tjgilbert/ece411/README.md

## ECE411 Practicum Project

**Project Focus:** Inductive Charging

**Team 10:** Jeff Brown, Katie Dahn, Tyler Gilbert, Jann Messer

*  [Project Wiki] (https://github.com/tjgilbert/ece411/wiki)
