tjgilbert/ece411/Docs/Assignment Docs/Homework3 source/ref.tex

\phantomsection
\addcontentsline{toc}{section}{References} %References don't show up in TOC on their own

\begin{thebibliography}{}

\bibitem{lecture}
Faust, Mark. "Requirements Specification" ECE 411 Industry Design Practices. Portland State University, Portland, OR. 18 October 2016. Lecture/PowerPoint

\bibitem{USB20}
"Universal Serial Bus Specification Revision 2.0"
\emph{Compaq Computer Corporation,
Hewlett-Packard Company, Intel Corporation, Lucent Technologies Inc,
Microsoft Corporation, NEC Corporation, Koninklijke Philips Electronics N.V.} \small{[\href{http://www.pjrc.com/teensy/beta/usb20.pdf\#page=206}{PDF DOCUMENT}]}, \normalsize 2000
 
\bibitem{appletemp}
"Keeping IPhone, IPad, and IPod Touch within Acceptable Operating Temperatures."
\emph{Apple Support.} N.p., 28 Sept. 2016. Web. 24 Oct. 2016. \url{https://support.apple.com/en-us/HT201678}

\bibitem{iprating}
"IP Rated Enclosures Explained"
\emph{The Enclosure Company (International) Ltd} N.p., n.d. Web. 23 Oct. 2016. \url{http://www.enclosurecompany.com/ip-ratings-explained.php}

\bibitem{forbes}
"How Often Do Americans Upgrade Their Smartphones?" \emph{Forbes.} Forbes Magazine, 9 July, 2015. Web. 24 Oct. 2016.

\rhead{ \fancyplain{}{References} }

\end{thebibliography}
% that's all folks
