tjgilbert/ece411/Docs/Presentation/PowerPointT10.pptx

## A Modest Inductive Charger

Team 10 – Jeff Brown Kati Dahn Tyler Gilbert Jann Messer

## Pitfalls of Wired Charging

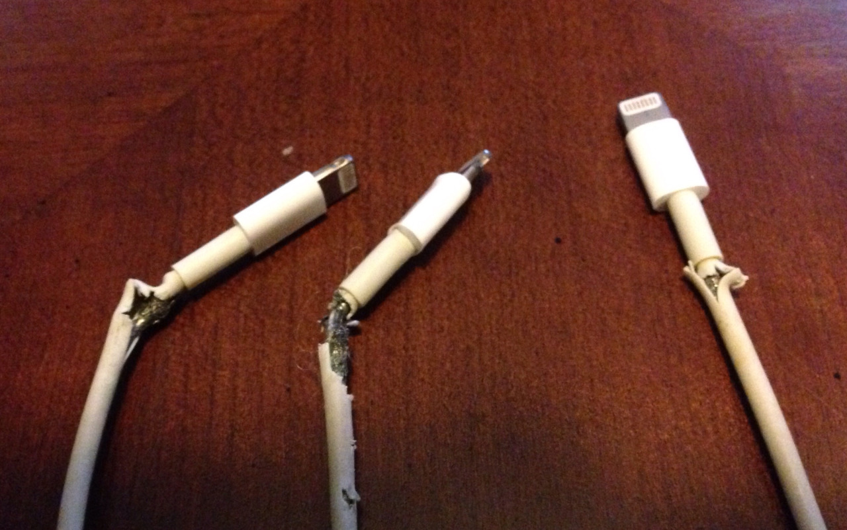
[picture p1: figure]
Image result for frayed usb cord
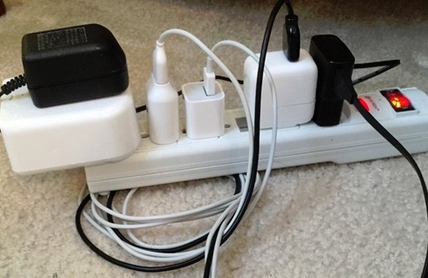
[picture p2: figure]
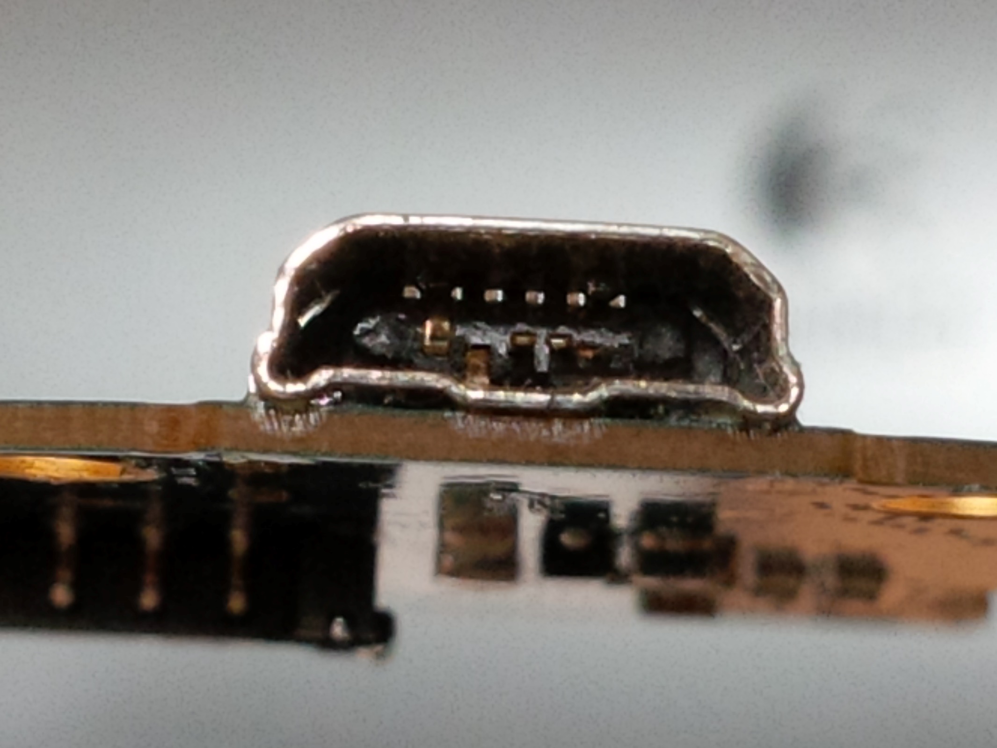
[picture p3: figure]

## Guiding Motivation

- “To become more familiar with wireless energy transmission and explore integrating wireless charging technology into consumer electronics.”
- A starting point for exploring Power solutions for the internet of things

## Objective

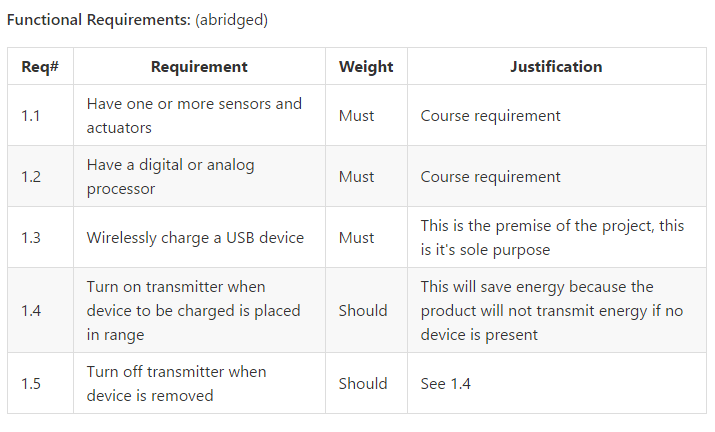
[picture p4: figure]
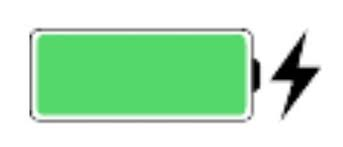
[picture p5: figure]
Image result for charging indicator icon

## Alternatives

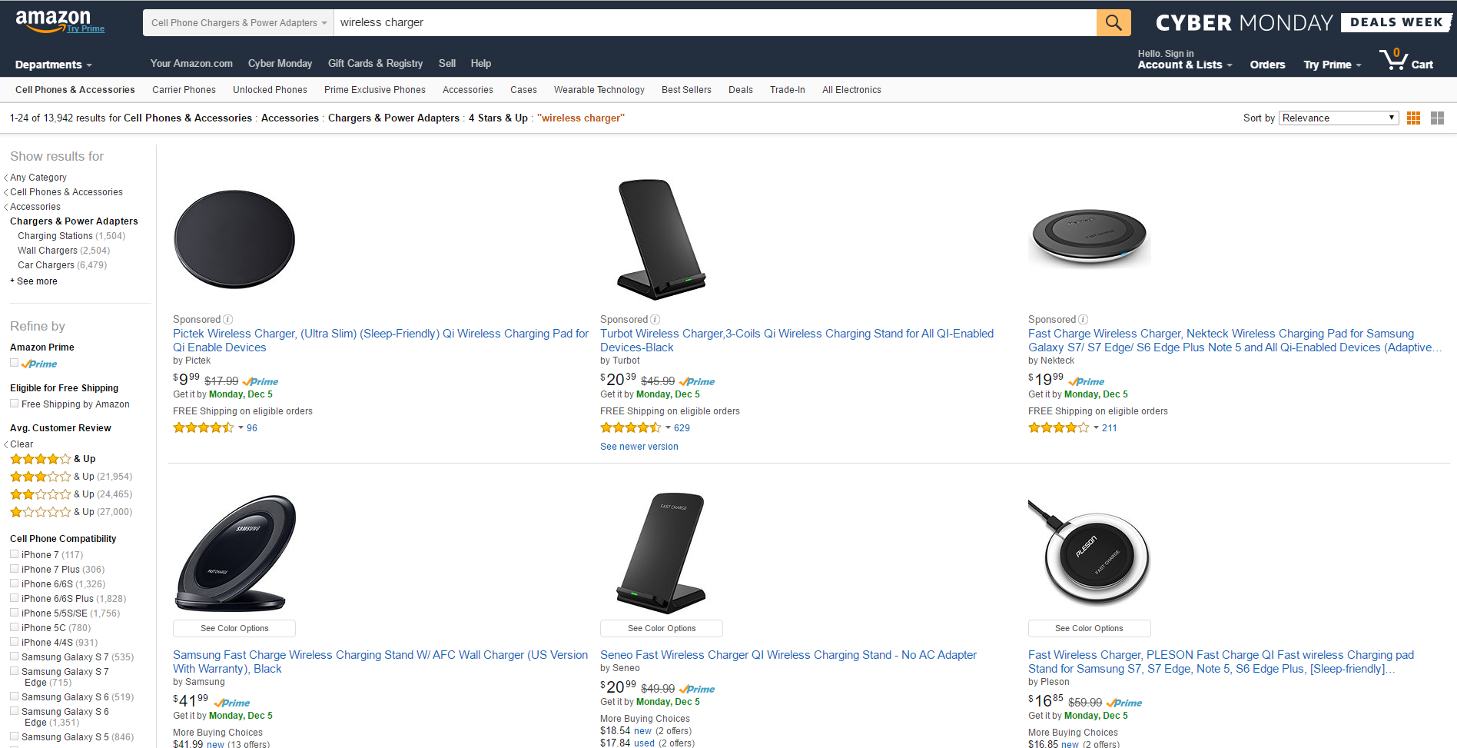
[picture p6: figure]
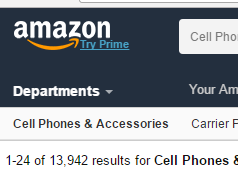
[picture p7: figure]

- We are by no means re-inventing the wheel here.

## Requirements

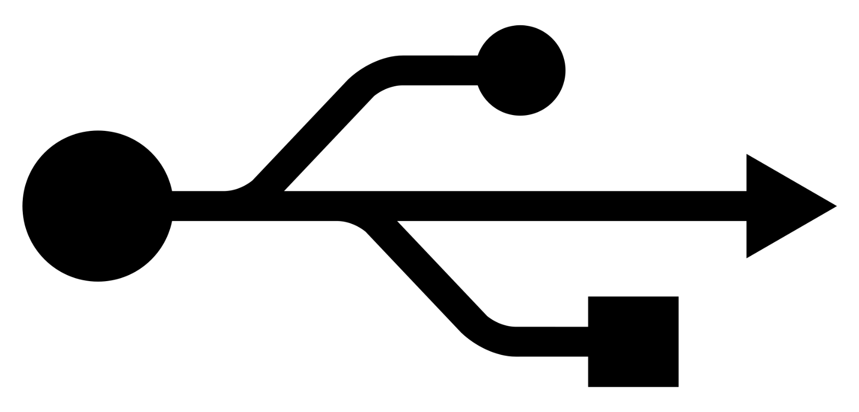
[picture p8: figure]
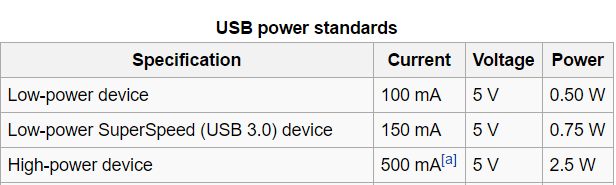
[picture p9: figure]

## Approach

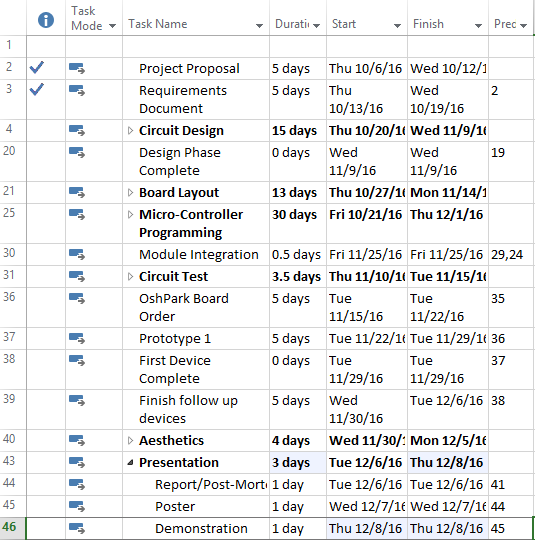
[picture p10: figure]

- Block Diagram of Modules
- Design Coils
- Design Signal Driver
- Program Controller
- Regulation and Rectification Circuitry
- Integration
- Testing

## Circuit Design

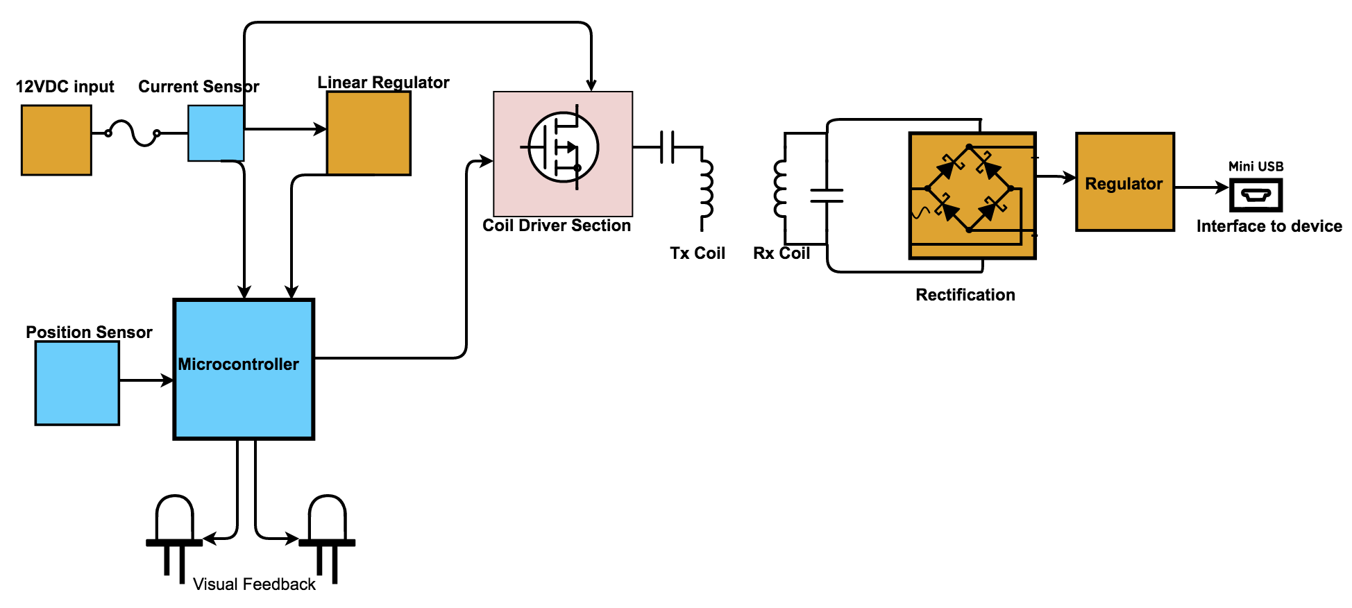
[picture p11: figure]

## Coil Design

## Driver Design

## Regulation and Rectification

## Microcontroller software Design

## Implementation slide 1 of 2

- Details

## Implementation 2 bill of materials and Tools

## IP and Prior WOrk

## Testing

## Results

## Contributions

## Lessons Learned
