tjgilbert/ece411/Docs/Assignment Docs/Homework3 source/title_toc.tex

\thispagestyle{empty}   % removes page numbering for title page

\begin{figure}[t]
    \begin{center}
    {\huge \textsc{ Product Design Specifications}}
    \end{center}

    \begin{center}
    \LARGE Inductive Charging
    \end{center}

    \begin{center}
    \normalsize \textit{Practicum Team 10}
    \end{center}
\end{figure}

\vspace*{\fill}

\begingroup
    \begin{center}
    
    \end{center}
\endgroup
    
\vspace*{\fill}
    
\begin{figure}[b]
    
\end{figure}

% Contact info footer
    \begin{figure}[!b]
    \begin{center}
    \rule{6in}{0.4pt}
    \begin{minipage}[t]{.75\textwidth}
    \begin{tabular}{llcccll}
    \textbf{Team Members:}  Tyler Gilbert, Kati Dahn, Jann Messer, Jeff Brown & & & &\\
    \textbf{Project repository:} \href{https://github.com/tjgilbert/ece411}{https://github.com/tjgilbert/ece411} \\
    \end{tabular}
    \end{minipage}
    \rule{6in}{0.4pt}
    \end{center}
    \end{figure}
    
\cleardoublepage
\phantomsection

\hypertarget{MyToc}{} %For linking back to the TOC
\rhead{ \fancyplain{}{Table of Contents} }
\begin{center}
{\Large \textsc{ Table of Contents}}
\end{center}
\renewcommand{\contentsname}{}
\tableofcontents

\cleardoublepage
