tjgilbert/ece411/HW6TitlePage.JPG

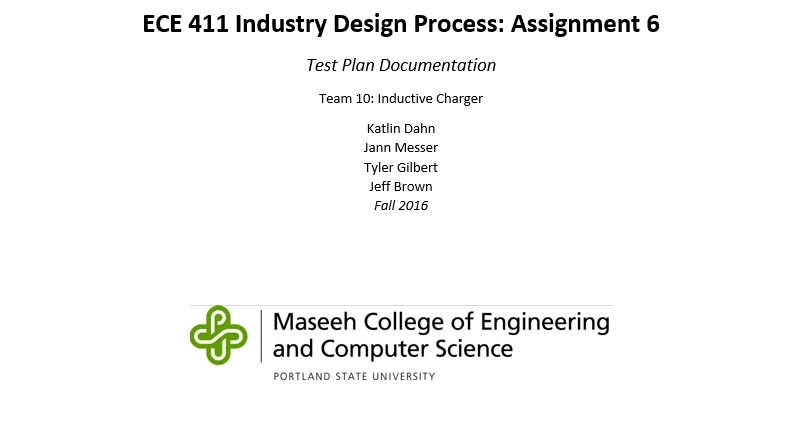
HW6TitlePage.JPG
