tjgilbert/ece411/ToCHW6.jpg

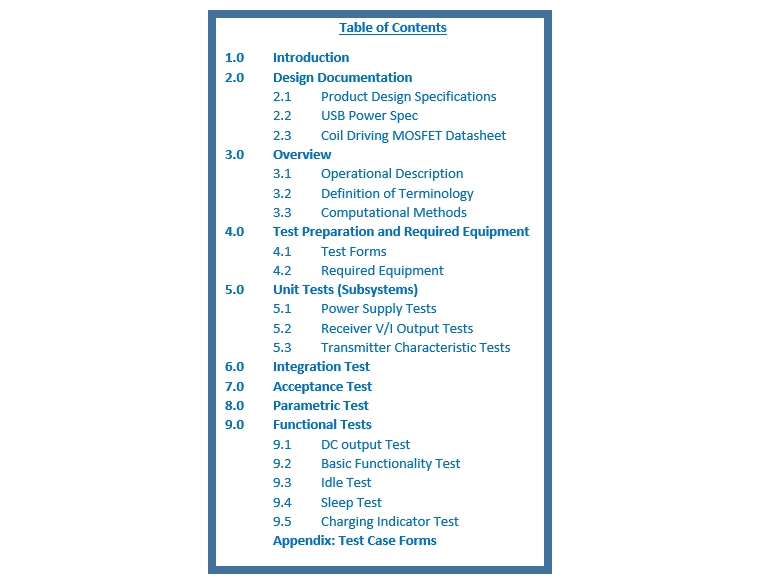
ToCHW6.jpg
