tjgilbert/ece411/Docs/Output-Stage-Tests/Capture 1.png

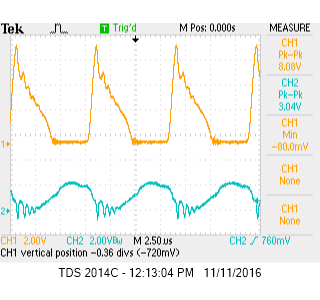
Docs/Output-Stage-Tests/Capture 1.png
