tjgilbert/ece411/Docs/Output-Stage-Tests/Capture 2.png

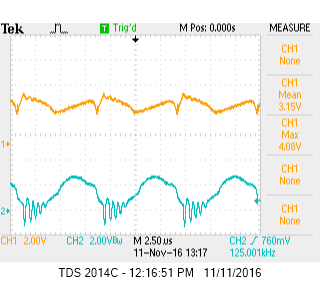
Docs/Output-Stage-Tests/Capture 2.png
