tjgilbert/ece411/Docs/Output-Stage-Tests/Capture 3.png

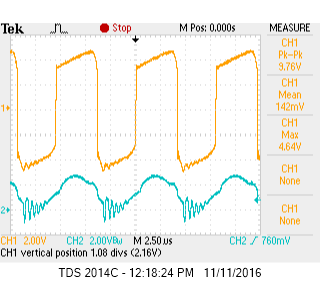
Docs/Output-Stage-Tests/Capture 3.png
