tjgilbert/ece411/Docs/Output-Stage-Tests/Capture 4.png

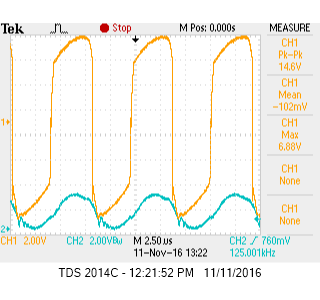
Docs/Output-Stage-Tests/Capture 4.png
