tjgilbert/ece411/Docs/Output-Stage-Tests/Capture 5.png

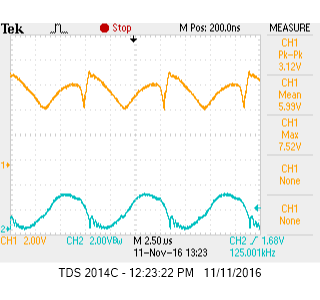
Docs/Output-Stage-Tests/Capture 5.png
