tjgilbert/ece411/Docs/Output-Stage-Tests/Capture 6.png

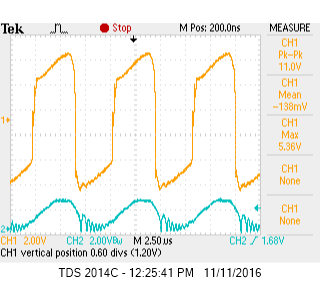
Docs/Output-Stage-Tests/Capture 6.png
