tjgilbert/ece411/Docs/Output-Stage-Tests/Capture 7.png

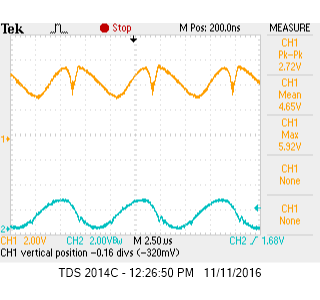
Docs/Output-Stage-Tests/Capture 7.png
