tjgilbert/ece411/Docs/Output-Stage-Tests/Capture 8.png

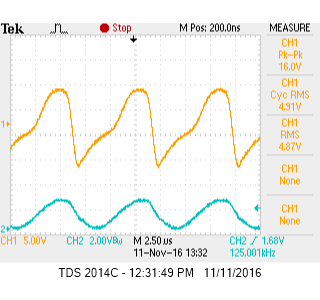
Docs/Output-Stage-Tests/Capture 8.png
