tjgilbert/ece411/Docs/Sample Charging Characterization/FFT.png

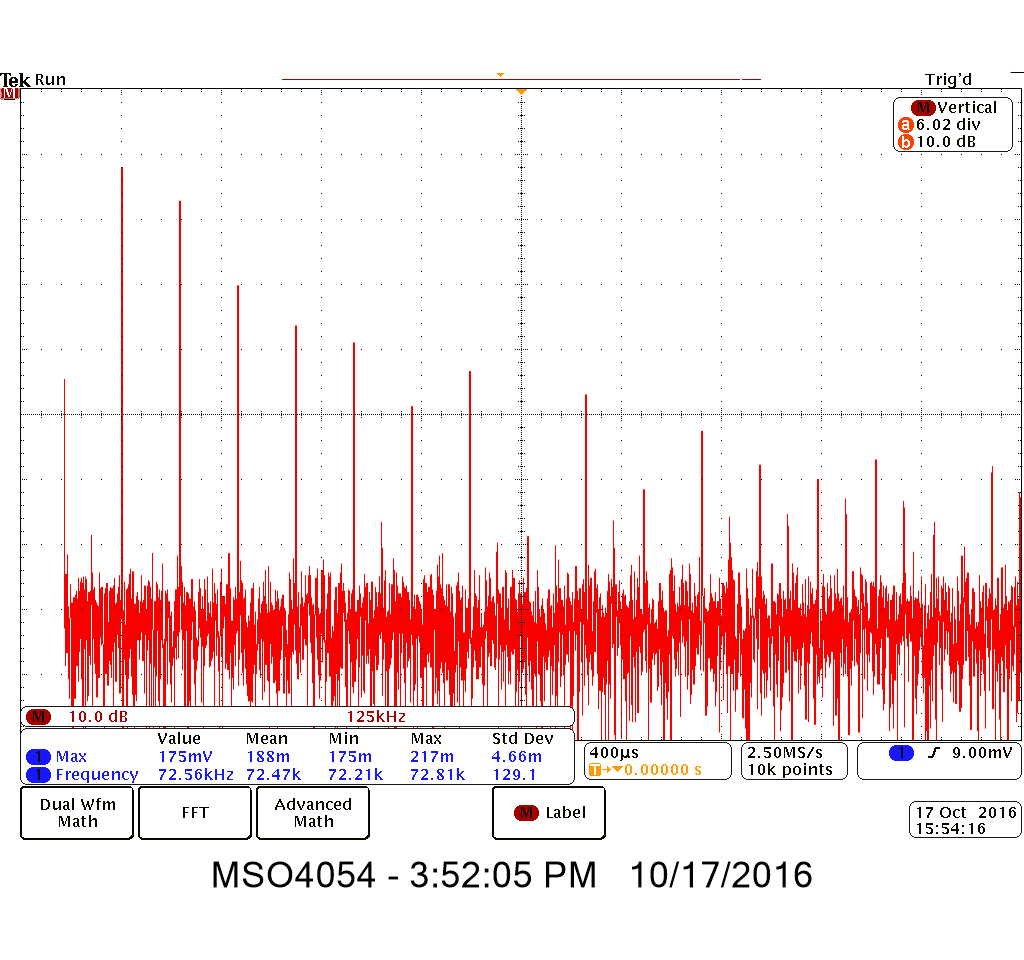
Docs/Sample Charging Characterization/FFT.png
