tjgilbert/ece411/Docs/Sample Charging Characterization/testsetup.jpg

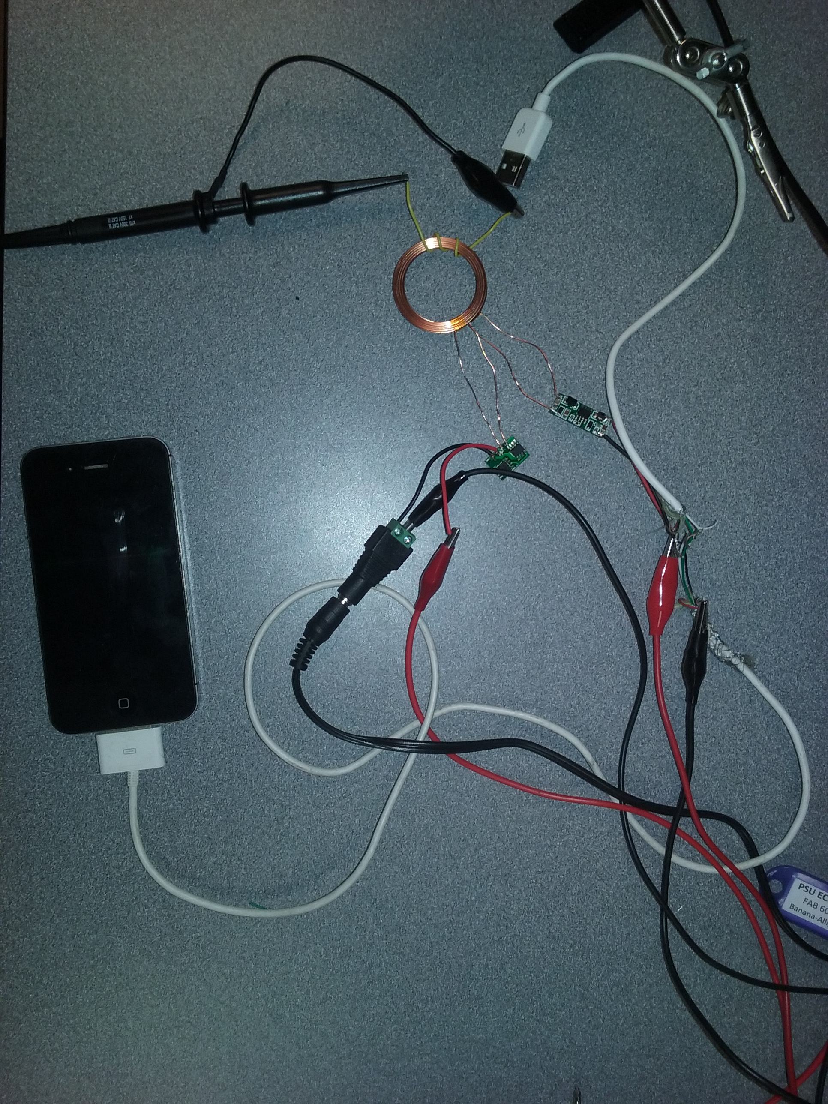
Docs/Sample Charging Characterization/testsetup.jpg
