tjgilbert/ece411/Docs/Sample Charging Characterization/waveform_loaded.png

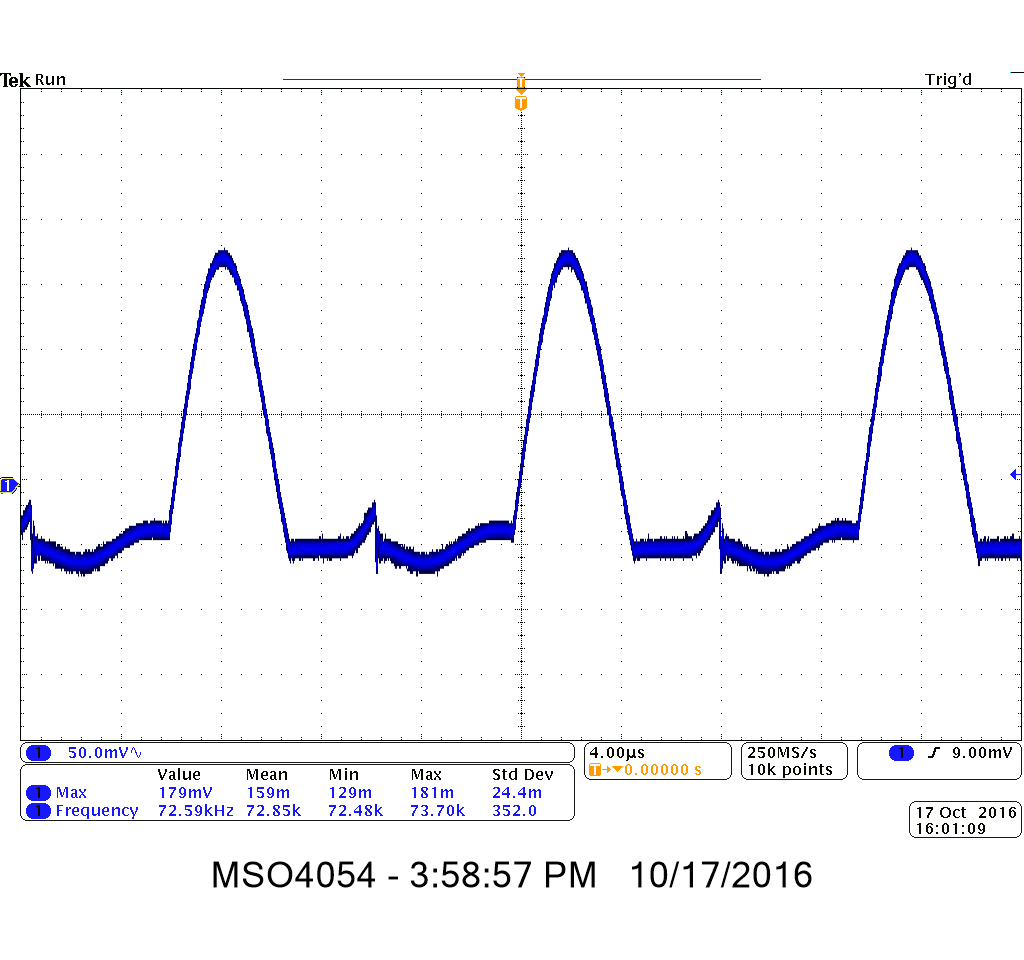
Docs/Sample Charging Characterization/waveform_loaded.png
