tjgilbert/ece411/TestCase522CurrentOut.PNG

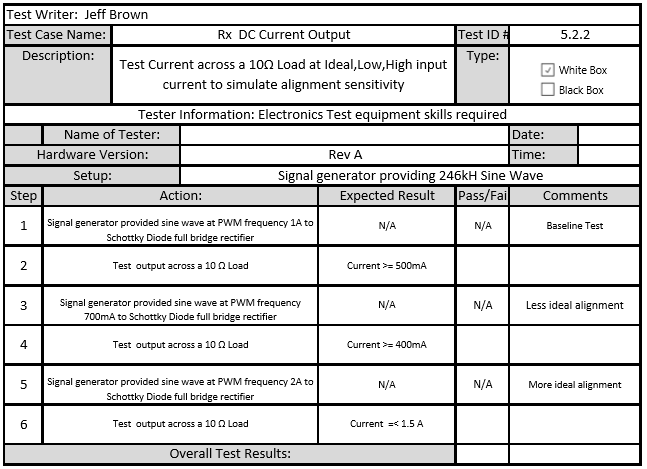
TestCase522CurrentOut.PNG
