tjgilbert/ece411/TestCaseDCoutR2.PNG

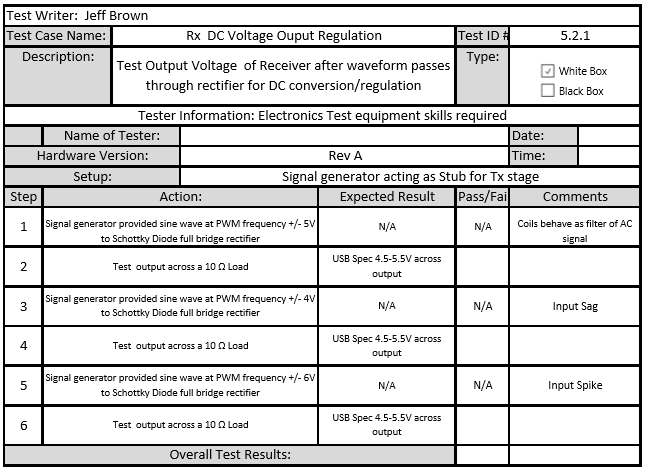
TestCaseDCoutR2.PNG
