tjgilbert/ece411/TestCaseMCUpwm.png

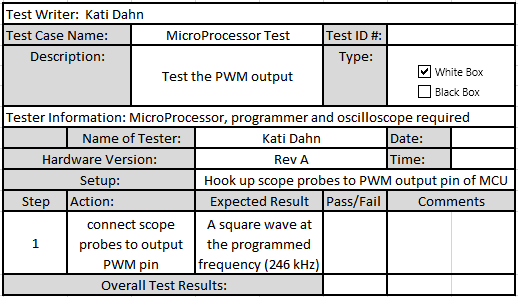
TestCaseMCUpwm.png
