tjgilbert/ece411/TestCaseMCUswitch.png

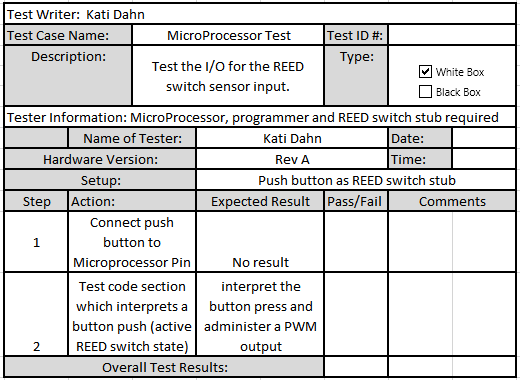
TestCaseMCUswitch.png
