tjgilbert/ece411/TestCaseTemperatureEnclosure.png

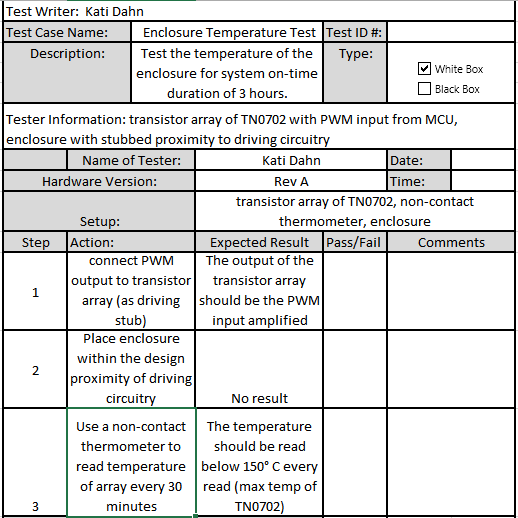
TestCaseTemperatureEnclosure.png
