tjgilbert/ece411/TestCaseTemperatureTransistors.png

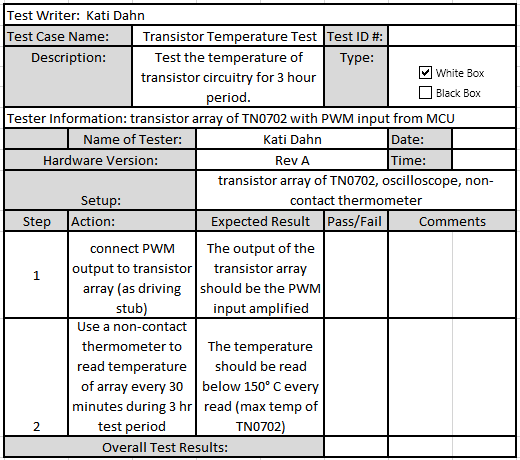
TestCaseTemperatureTransistors.png
