tjgilbert/ece411/(threads)

Thread 1 (2016-10-17):

Make Coil Winding Jig

tjgilbert, 2016-10-17:

jmesserpdx, 2016-10-18:
Jeff bought some Lexan for the coil form. Need to cut slot in top piece to feed wire through. Must also have a working drawing for the form at some point but will probably "wing" one on a drill press to get rolling.

tjgilbert, 2016-10-18:
I got some Litz wire in. I'll bring it in tomorrow (10/18)

dahnk, 2016-10-18:
We aren't doing high frequencies now, right? At most around 150kHz? And the amperage should be quite low as well, is this correct?
If these assumptions are correct I believe we could get away with some simple magnetic wire or a smaller gauge, like 22 or 18 AWG. This is easy enough to get from the LID for our prototyping

jEfEpdx, 2016-10-18:
Yea I am planning to test a small gauge and large gauge magnet wire
tomorrow and characterize the frequency response.

I am not sure on current draw. Less than 2 amps.

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

--
*Jeff Brown*
*Electrical Engineer*

Portland State University
Maseeh College of Engineering

Closed 2016-10-30.

Thread 5 (2016-10-18):

Characterize Adafruit IC Module

jmesserpdx, 2016-10-18:
Characterize performance of the Adafruit IC module. Record current and voltages at various coil orientations. Capture Oscillograph of waveform and FFT of same.

jmesserpdx, 2016-10-18:
Have obtained waveform and FFT on the transmitter coil with a pickup coil. Need to measure usable working distance of coils.

Closed 2016-11-01.

Thread 6 (2016-10-18):

Characterize Load Profile of various mobiles

jmesserpdx, 2016-10-18:
Need to see how various phones current draws vary with how the battery is charging. Tyler is looking into the iPhone charging profile. Will provide info for designing the  impedance sensing circuitry in the transmitter section.

jmesserpdx, 2016-10-18:
A logging multi-meter would be nice for this. The capstone lab meters have an RS-232 port so I'll look into the manual to see if we can interface to the computer and make pretty graphs.

tjgilbert, 2016-10-18:
I don't think it is necessary to do multiple devices yet. It will be different on our transformer.  I would just categorize this under de-risking.

tjgilbert, 2016-10-19:
**Iphone 4:**

|          | Tx    | Rx    | Wall  |
|----------|-------|-------|-------|
| Charging | 551mA | 736mA |       |
| Standby  | 85mA  | 0     | 0     |
| No Load  | 77mA  | 0     | 0     |
| 90%      | 138mA | 90mA  | 400mA |
| 100%     |       |       | 190mA |

jEfEpdx, 2016-10-19:
So the device draws less current when at 100%. Good! Tyler was this using the kit go test?

dahnk, 2016-10-19:
That's good then we can detect the drop in current, by a voltage drop
across some precision resistor?

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

jEfEpdx, 2016-10-19:
I have a whole set of 1% 'ers still in the box if they would work

Closed 2016-10-30.

Thread 8 (2016-10-18):

develop general program algorithm for uC

dahnk, 2016-10-18:

dahnk, 2016-11-02:
Algorithm:

Setup:
Set up pins for inputs and outputs
Set up PWM specs
Set up baud rate for serial debugging (useful with atmel studio but not strictly necessary )
Set up protective internal pullup/pull-down resistors

Main program loop:
Read REED sensor
If REED sensor is activated (high/low whichever)
Then send PWM signal to tranceiver coil circuitry
Else do not send PWM signal
Loop back

tjgilbert, 2016-11-16:
Lets make a state diagram

Thread 9 (2016-10-18):

develop test code to test uC program

dahnk, 2016-10-18:
* Where could it fail?
* What are edge case input values
* How well will the algorithm reject or ignore useless or incorrect data?

tjgilbert, 2016-11-16:
Lets program a test case to accept a button press (Reed switches - active low) on **PA1** and activate two outputs (the LEDs) **PA2** and **PA3**

if we can test before Thursday that would be the best.

Thread 11 (2016-10-19):

Characterize resonance frequency

jEfEpdx, 2016-10-19:
Test different wire garages/ and N turns per type.

tjgilbert, 2016-10-20:
L (uH) = r^2 * n^2 / (8 * r + 11 * w)
where:
r = radius to center of windings in inches
w = width of windings (in inches)
n = number of turns

[Harold A. Wheeler, "Simple Inductance Formulas for Radio Coils," Proceedings of the I.R.E., October 1928, pp. 1398-1400.](http://ieeexplore.ieee.org/stamp/stamp.jsp?arnumber=1669896)

tjgilbert, 2016-11-01:
125kHz

Closed 2016-11-01.

Thread 12 (2016-10-25):

Preliminary Schematic, no ERC errors

tjgilbert, 2016-10-25:

tjgilbert, 2016-11-16:
Go over checklist before thursday

Thread 14 (2016-10-25):

Need preliminary design for coil driving circuitry

tjgilbert, 2016-10-25:
Need design for coil driving circuitry, ie.   mosfets, capacitors, resistors,   Part sizes do not matter, we can change that later.

jmesserpdx, 2016-11-10:
This issue continues to persist. I'm going to try some new components tomorrow. This will probably become a blocking issue if we don't sort it by the weekend.

Have Tested the following configurations

Single transistor pair Class B output stage - Doesn't source enough current and seems to draws to much base current for lab signal generator.

Parallel transistor Class B Output Stage with Current buffer - Sort of worked. Got around 3Vpp at output coil but waveform was fairly distorted. Only NPN devices seem to work need to determine if design flaw or bad components.

Sziklai pair Complementary Symmetry - Insufficient output swing @ around 2 Vpp and less than 200mA current draw. Could be promising.

tjgilbert, 2016-11-16:
n-type mosfet array driven by square wave, common source

Closed 2016-11-16.

Thread 15 (2016-11-03):

Receiver schematic

dahnk, 2016-11-03:
We have some pics from the meeting on Tuesday in the LID of the output receiver schematic.
pic of this from the whiteboard to be uploaded

Also I have been doing some LTspice simulations and designs.
circuit schematic and simulations to be uploaded

A choice of design must be made and receiver circuit built prototyped and tested

tjgilbert, 2016-11-03:
[ ]  pick a zener diode

jEfEpdx, 2016-11-03:
5v Zeners are pretty common and don't very much across process. True not
true but they are easy to measure. Ended up meeting my dad tonight downtown
to watch the Cubs lift their curse.

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

--
*Jeff Brown*
*Electrical Engineer*

Portland State University
Maseeh College of Engineering

tjgilbert, 2016-11-16:
![Uploading Screen Shot 2016-11-15 at 11.52.53 PM.png…]()

tjgilbert, 2016-11-16:
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

Closed 2016-11-16.

Thread 16 (2016-11-10):

choose op amps for filter stage

dahnk, 2016-11-10:
Need to handle frequencies around 125Khz

the LT1022 can handle it, it has an acceptable slew rate

here is the digikey link:
http://www.digikey.com/product-search/en/integrated-circuits-ics/linear-amplifiers-instrumentation-op-amps-buffer-amps/2556125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

jmesserpdx, 2016-11-10:
If we do a passive filter we may need only a simple transistor CC or CE amp to boost it for the output stage.

dahnk, 2016-11-10:
I agree, currently simulating with active but will also simulate passive
with bjt amplifier following

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

jmesserpdx, 2016-11-10:
When you simulate BJT see if you can get an offset of 7.2 and 6.6 Volts with the follower. Then the output node can be at Vcc/2

dahnk, 2016-11-12:
I have a bunch of TL740cn JFET op amps and these are working really well, I don't think we need to order anything else, but we can just for more testing, but the slew rate on these is more than sufficient to handle our 125kHz input signal.

Closed 2016-11-12.

Thread 17 (2016-11-10):

Find Appropriate Output transistors

jmesserpdx, 2016-11-10:
The current stable of LM3046s, MPQ2907s, and 3904s may not be relied upon. Too many are burnt out or otherwise damaged. We'd save precious lab time replacing them.

However :
Doing a rough calculation if we deliver 6 watts into the 10uH coil at 120 KHz we need to source 900 mA. We could parallel 3904/6's which I will try. We may also consider something like a TIP 41/2 pair but the drive current would demand a current preamp.

To Try:

Parallel 3904/6s
2N3055 and whatever PNP goes with it
TIP 41/2 or like pair w/ 3904 CC amp

jEfEpdx, 2016-11-10:
Just woke up. Slept 7 hours which is quite a bit more than usual.

I can be on campus by 8, Can't drop the dog off until 7:30. I am looking
through results from last night and will start coming up with a few ideas
to try

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

--
*Jeff Brown*
*Electrical Engineer*

Portland State University
Maseeh College of Engineering

tjgilbert, 2016-11-16:
TN0702 [(datasheet)](http://ww1.microchip.com/downloads/en/DeviceDoc/TN0702%20C080813.pdf) x 5  or [RFD16N05LSM9ACT (datasheet)](https://www.fairchildsemi.com/datasheets/RF/RFD16N05LSM.pdf)

Closed 2016-11-16.

Thread 18 (2016-11-10):

Characterize Jeff's Coils

jmesserpdx, 2016-11-10:
Maybe we can solder them onto the Adafruit kit and see if they are feasible that way. They seem small but if they work that can be our "market edge".

Need:
Inductance
DC Resistance
     - If we end up direct coupling them we may need to see if they can handle the Quiescent current         
Sensitivity to orientation and placement
      - Some metric needs to be defined like "50% coupling at 1/4" displacement from center"
         maybe Qi standard has a metric we can use.

tjgilbert, 2016-11-16:
Do we still want to try to use these?
Litz coils were 20uH self inductance and 140pF parallel capacitance. Resonant frequency ~2.8MHz, max power transfer @ 246kHz

tjgilbert, 2016-12-02:
too late

Closed 2016-12-02.
