tjgilbert/ece411/Eagle/ISP_POGO_programmer.pdf

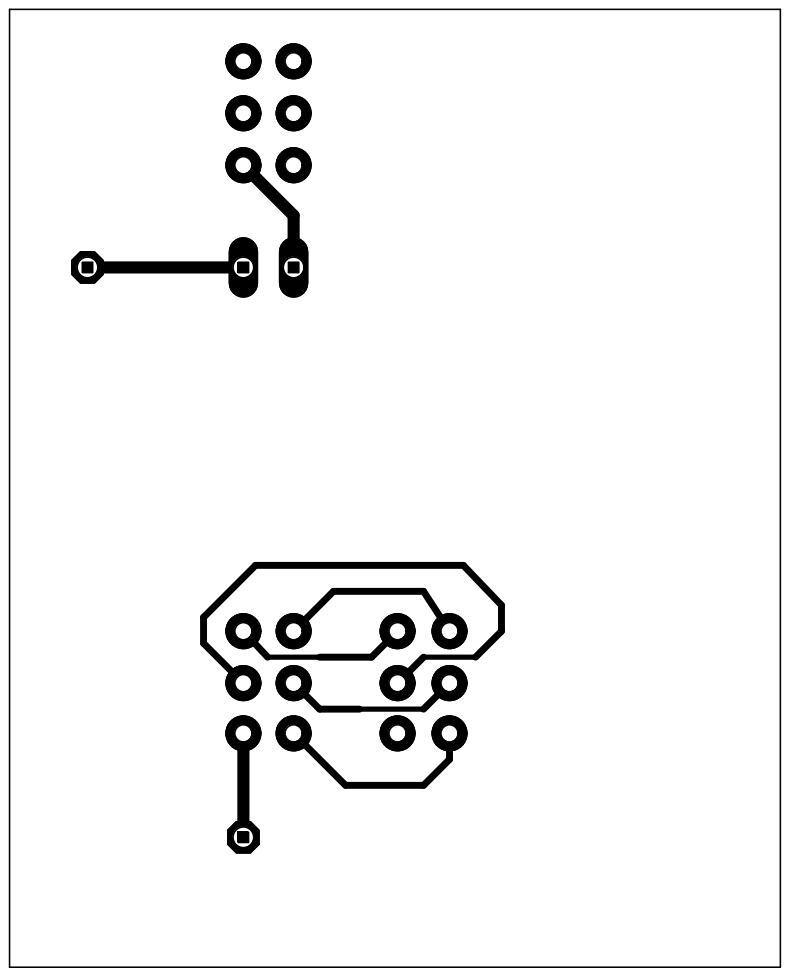
[picture p31: page 1]
