tjgilbert/ece411/Docs/Presentation/T10-StateDiagram _v3.pdf

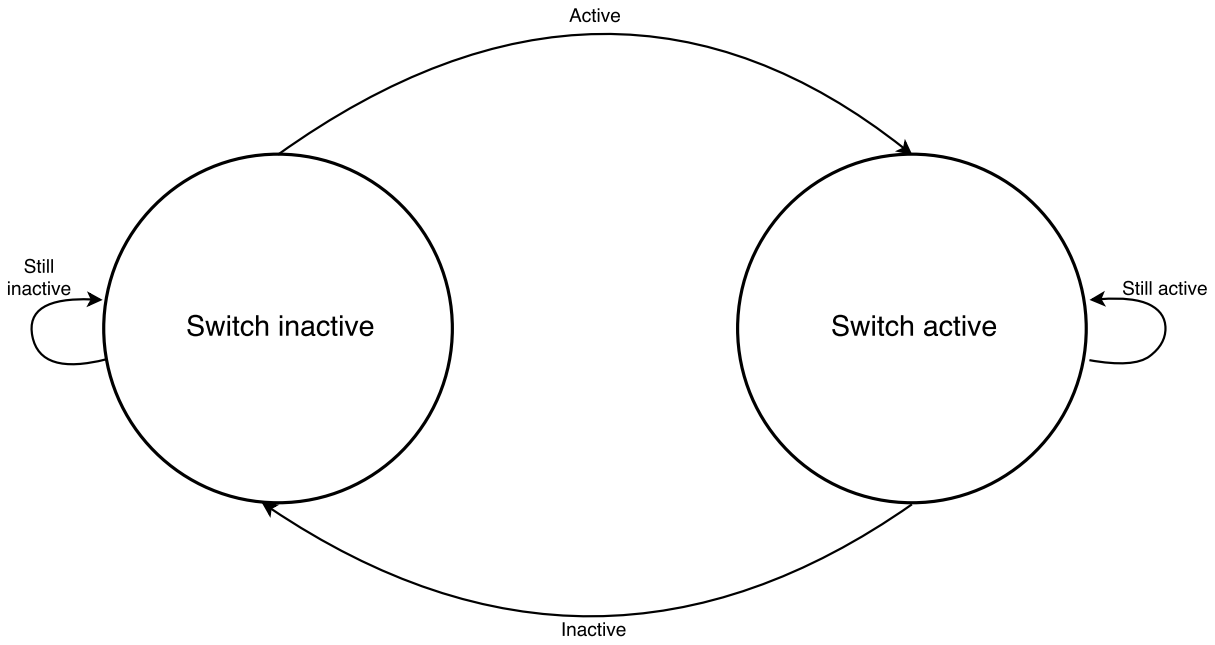
[picture p32: page 1]
