tjgilbert/ece411/Docs/Presentation/T10-ProgramFlow_v1.pdf

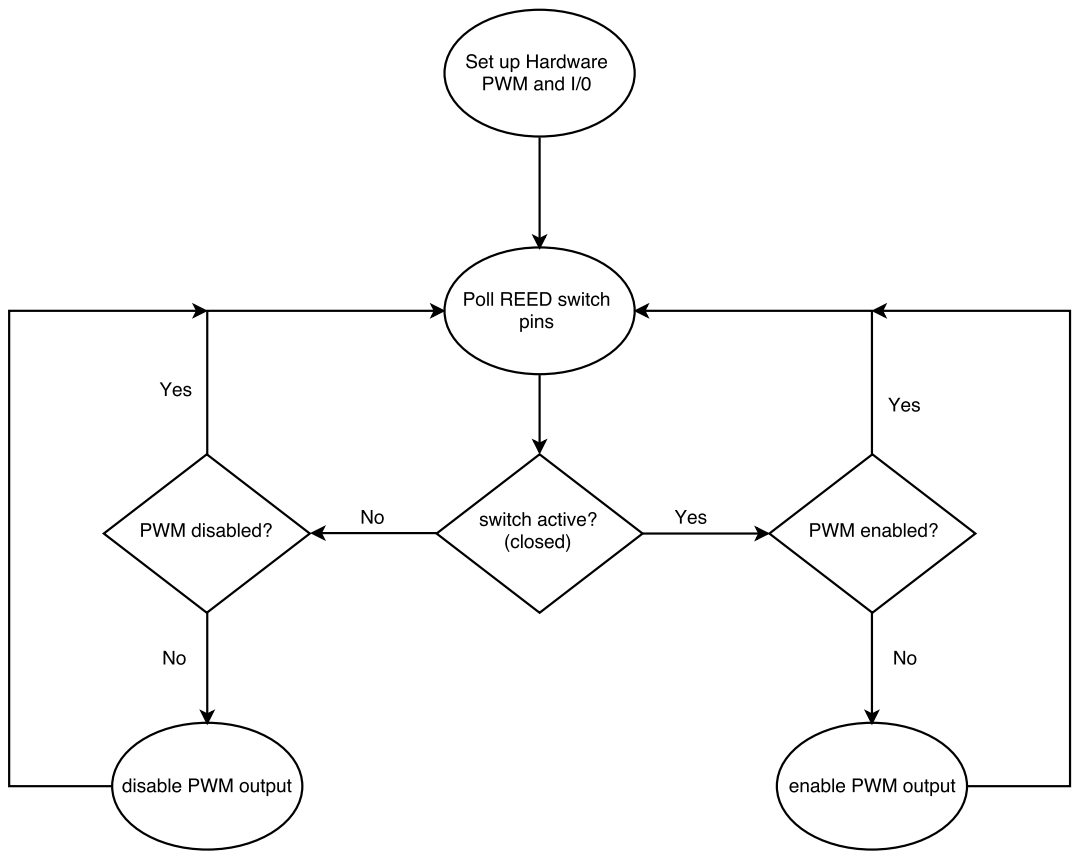
[picture p33: page 1]
