tjgilbert/ece411/CompSym_OutputStage.asc

C2: cap; 10µ
C3: cap; 10µ
L1: ind; 10µ
Q1: npn; 2N3904
Q2: npn; 2N3904
Q3: npn; 2N3019
Q4: pnp; 2N3906
Q5: npn; 2N3019
R1: res; 1k
R2: res; 5.6k
R3: res; 4k
R4: res; 4k
V1: voltage; 12
V2: voltage; SINE(0 5 120k)
Named nets: 0, Vcc, Vin
.op
Ic Q3
Ic Q5
I of R3
Complementary Symmetry Output Stage
