tjgilbert/ece411/Receiver_9vBattery.asc

C1: polcap; 10p
C2: cap; .01p
C3: cap; .01µ
D1: schottky; 1N5819
D2: schottky; 1N5819
D3: schottky; 1N5819
D4: schottky; 1N5819
D5: zener; 1N750
R1: res; 50
R2: res; 100
U1: LM741
V1: voltage; SINE(0 6 125k)
V2: voltage; 9
Named nets: 0, V+
.tran 200us
