tjgilbert/ece411/Eagle/ece411-t10-ChargerBase.brd

## EAGLE design Eagle/ece411-t10-ChargerBase.brd (2016-12-08)

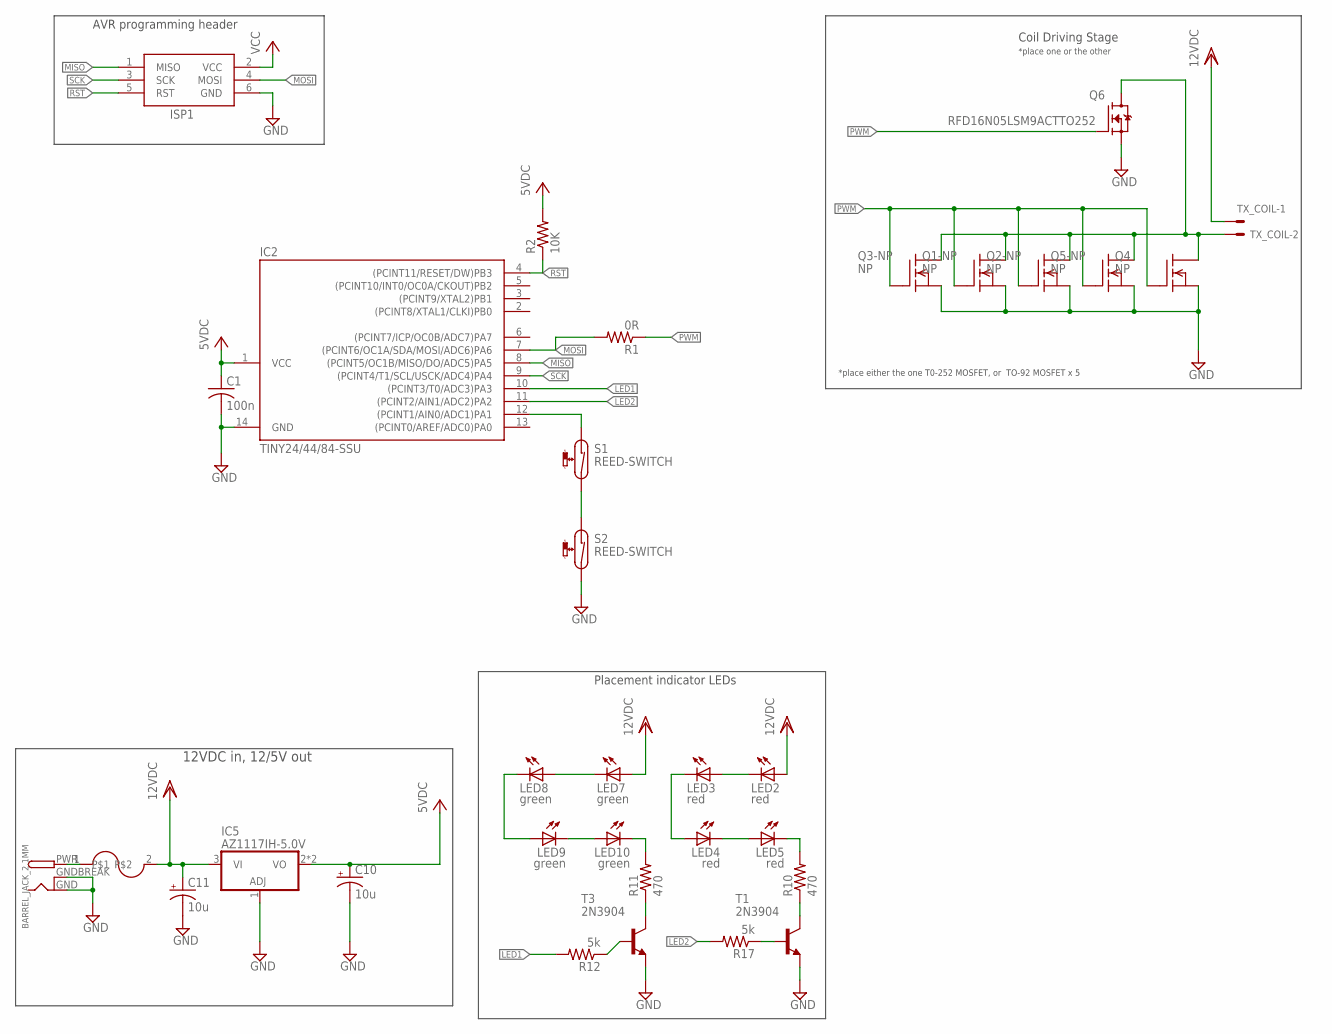
[picture p34: schematic ece411-t10-ChargerBase.sch]

Parts:
BARREL_JACK_2.1MM: DCBARRELPTH; DCJACK_2MM_PTH
C1: 100n; C0805
C10, C11: 10u; E2-5
IC2: TINY24/44/84-SSU; SOIC14
IC5: AZ1117IH-5.0V; SOT223
ISP1: AVRISP-6; AVRISP
LED2, LED3, LED4, LED5: red; CHIPLED_0805
LED7, LED8, LED9, LED10: green; CHIPLED_0805
Q1-NP, Q2-NP, Q3-NP, Q4, Q5-NP: NP; TO-92
Q6: RFD16N05LSM9ACTTO252; TO252
R1: 0R; R0805
R2: 10K; R0805
R10, R11: 470; R0805
R12, R17: 5k; R0805
S1, S2: REED-SWITCH; MK6-6
T1, T3: 2N3904; TO92
TX_COIL: 22-23-2021
U$1: LITTLEFUSE

Connections:
DRAIN: Q1-NP.3 (D), Q2-NP.3 (D), Q3-NP.3 (D), Q4.3 (D), Q5-NP.3 (D), Q6.3 (D), TX_COIL.2
GND: BARREL_JACK_2.1MM.GND, BARREL_JACK_2.1MM.GNDBREAK, C1.2, C10.-, C11.-, IC2.14 (GND), IC5.1 (ADJ), ISP1.6 (GND), Q1-NP.1 (S), Q2-NP.1 (S), Q3-NP.1 (S), Q4.1 (S), Q5-NP.1 (S), Q6.2 (S), S2.2, T1.3 (E), T3.3 (E)
LED1: IC2.10 ((PCINT3/T0/ADC3)PA3), R12.2
LED2: IC2.11 ((PCINT2/AIN1/ADC2)PA2), R17.2
MISO: IC2.8 ((PCINT5/OC1B/MISO/DO/ADC5)PA5), ISP1.1 (MISO)
MOSI: IC2.7 ((PCINT6/OC1A/SDA/MOSI/ADC6)PA6), ISP1.4 (MOSI), R1.2
unnamed: R11.1, T3.1 (C)
unnamed: LED10.C, R11.2
unnamed: BARREL_JACK_2.1MM.PWR, U$1.1
unnamed: R17.1, T1.2 (B)
unnamed: R10.1, T1.1 (C)
unnamed: LED5.C, R10.2
unnamed: LED2.C, LED3.A
unnamed: LED3.C, LED4.A
unnamed: LED4.C, LED5.A
unnamed: S1.2, S2.1
unnamed: LED7.C, LED8.A
unnamed: LED8.C, LED9.A
unnamed: LED9.C, LED10.A
unnamed: R12.1, T3.2 (B)
PIN12: IC2.12 ((PCINT1/AIN0/ADC1)PA1), S1.1
PWM: Q1-NP.2 (G), Q2-NP.2 (G), Q3-NP.2 (G), Q4.2 (G), Q5-NP.2 (G), Q6.1 (G), R1.1
RST: IC2.4 ((PCINT11/RESET/DW)PB3), ISP1.5 (RST), R2.1
SCK: IC2.9 ((PCINT4/T1/SCL/USCK/ADC4)PA4), ISP1.3 (SCK)
VCC: C1.1, C10.+, IC2.1 (VCC), IC5.2 (VO), IC5.4 (VO), ISP1.2 (VCC), R2.2
VDD: C11.+, IC5.3 (VI), LED2.A, LED7.A, TX_COIL.1, U$1.2

Notes on the sheet:
AVR programming header
12VDC in, 12/5V out
Coil Driving Stage
Placement indicator LEDs
*place one or the other
*place either the one T0-252 MOSFET, or TO-92 MOSFET x 5

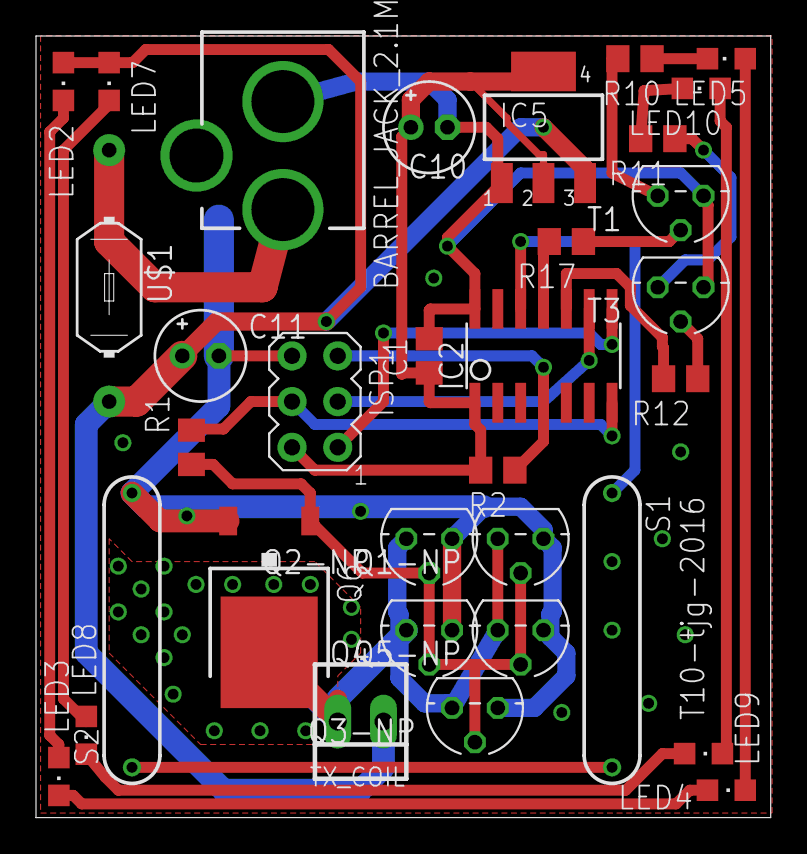
[picture p35: board ece411-t10-ChargerBase.brd from above]

Board: 2 copper layers, 40.8 x 43.4 mm, 33 parts (0 on the bottom side), 26 nets.
