tjgilbert/ece411/Eagle/ece411-t10-Receiver.brd

## EAGLE design Eagle/ece411-t10-Receiver.brd (2016-12-08)

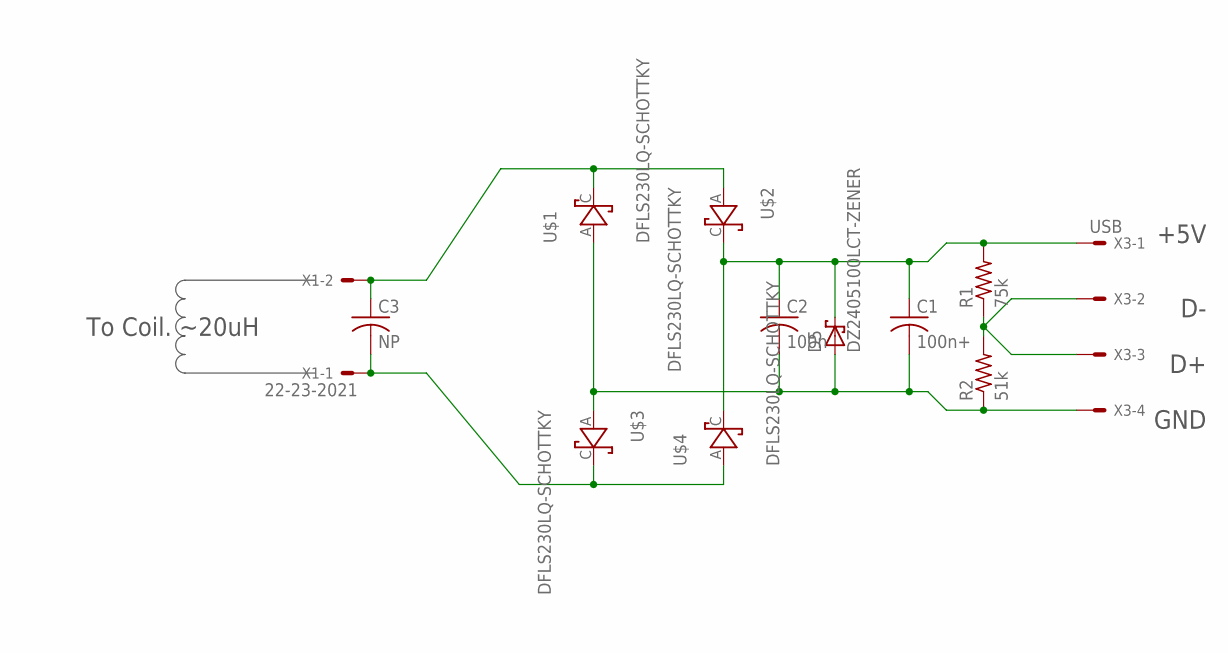
[picture p36: schematic ece411-t10-Receiver.sch]

Parts:
C1: 100n+; C0805
C2: 100n; C0805
C3: NP; C0805
D5: DZ2405100LCT-ZENER; ZENER_PWR_PKG
R1: 75k; R0805
R2: 51k; R0805
U$1, U$2, U$3, U$4: DFLS230LQ-SCHOTTKY; PWRDI123
X1: 22-23-2021
X3: USB; 22-23-2041

Connections:
5V: C1.1, C2.1, D5.C, R1.2, U$2.C, U$4.C, X3.1
GND: C1.2, C2.2, D5.A, R2.1, U$1.A, U$3.A, X3.4
unnamed: C3.1, U$1.C, U$2.A, X1.2
unnamed: C3.2, U$3.C, U$4.A, X1.1
unnamed: R1.1, R2.2, X3.2, X3.3

Notes on the sheet:
To Coil. ~20uH
+5V
GND

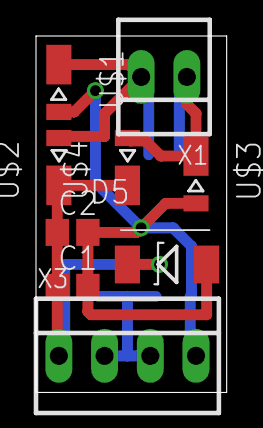
[picture p37: board ece411-t10-Receiver.brd from above]

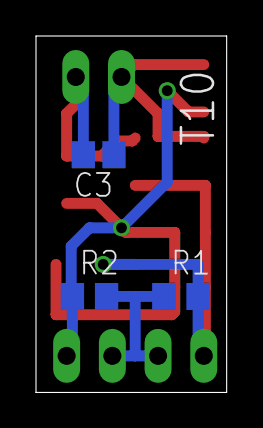
[picture p38: board ece411-t10-Receiver.brd from below]

Board: 2 copper layers, 10.6 x 19.8 mm, 12 parts (3 on the bottom side), 5 nets.
