tjgilbert/ece411/Eagle/ISP_POGO_programmer.brd

## EAGLE design Eagle/ISP_POGO_programmer.brd (2016-12-02)

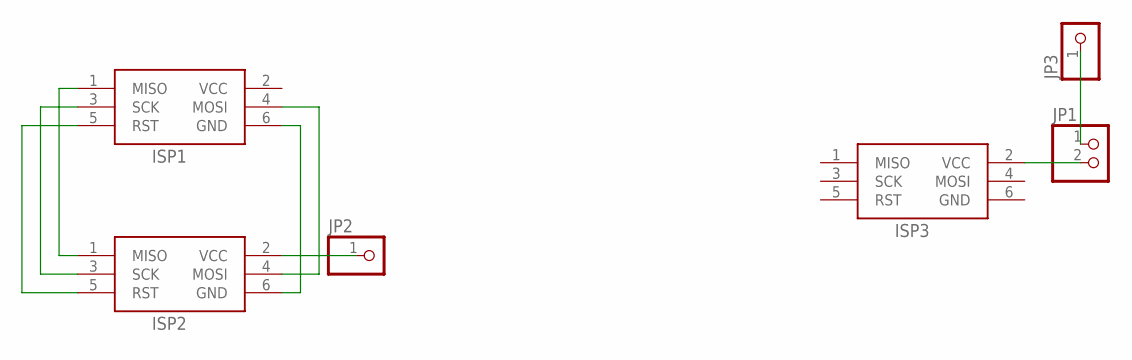
[picture p39: schematic ISP_POGO_programmer.sch]

Parts:
ISP1, ISP2, ISP3: AVRISP-6; AVRISP
JP1: PINHD-1X2; 1X02
JP2, JP3: PINHD-1X1; 1X01

Connections:
GND: ISP3.6 (GND)
unnamed: ISP1.1 (MISO), ISP2.1 (MISO)
unnamed: ISP1.3 (SCK), ISP2.3 (SCK)
unnamed: ISP1.5 (RST), ISP2.5 (RST)
unnamed: ISP1.6 (GND), ISP2.6 (GND)
unnamed: ISP1.4 (MOSI), ISP2.4 (MOSI)
unnamed: ISP3.2 (VCC), JP1.2
unnamed: JP1.1, JP3.1
unnamed: ISP2.2 (VCC), JP2.1
VCC: ISP1.2 (VCC)

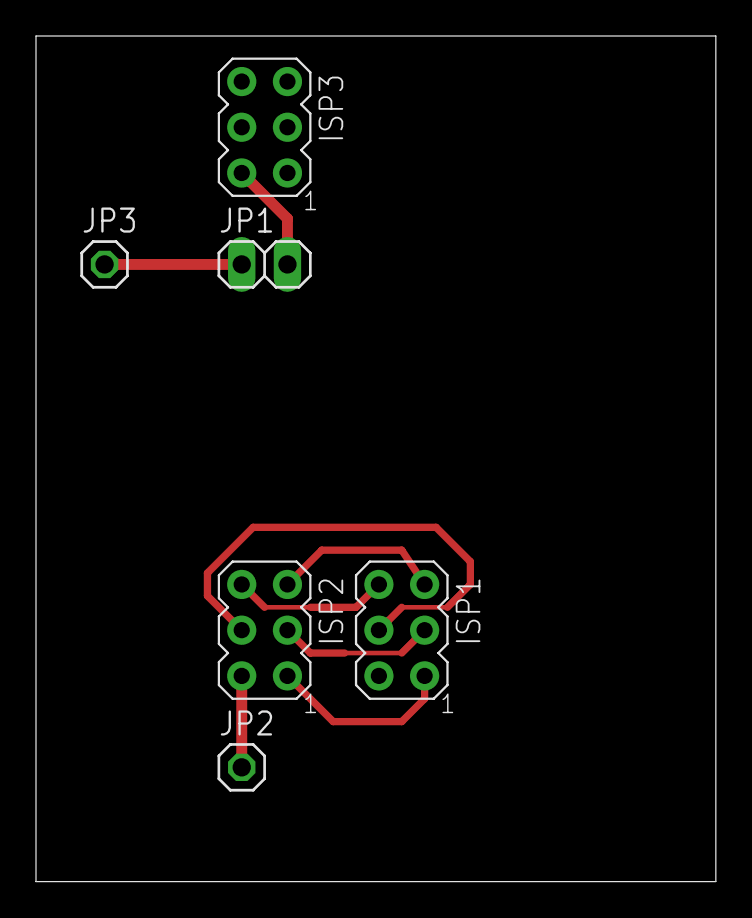
[picture p40: board ISP_POGO_programmer.brd from above]

Board: 2 copper layers, 37.8 x 47.0 mm, 6 parts (0 on the bottom side), 8 nets.
