tjgilbert/ece411/Eagle/test boards/ATTINY44_breakout.brd

## EAGLE design Eagle/test boards/ATTINY44_breakout.brd (2016-11-02)

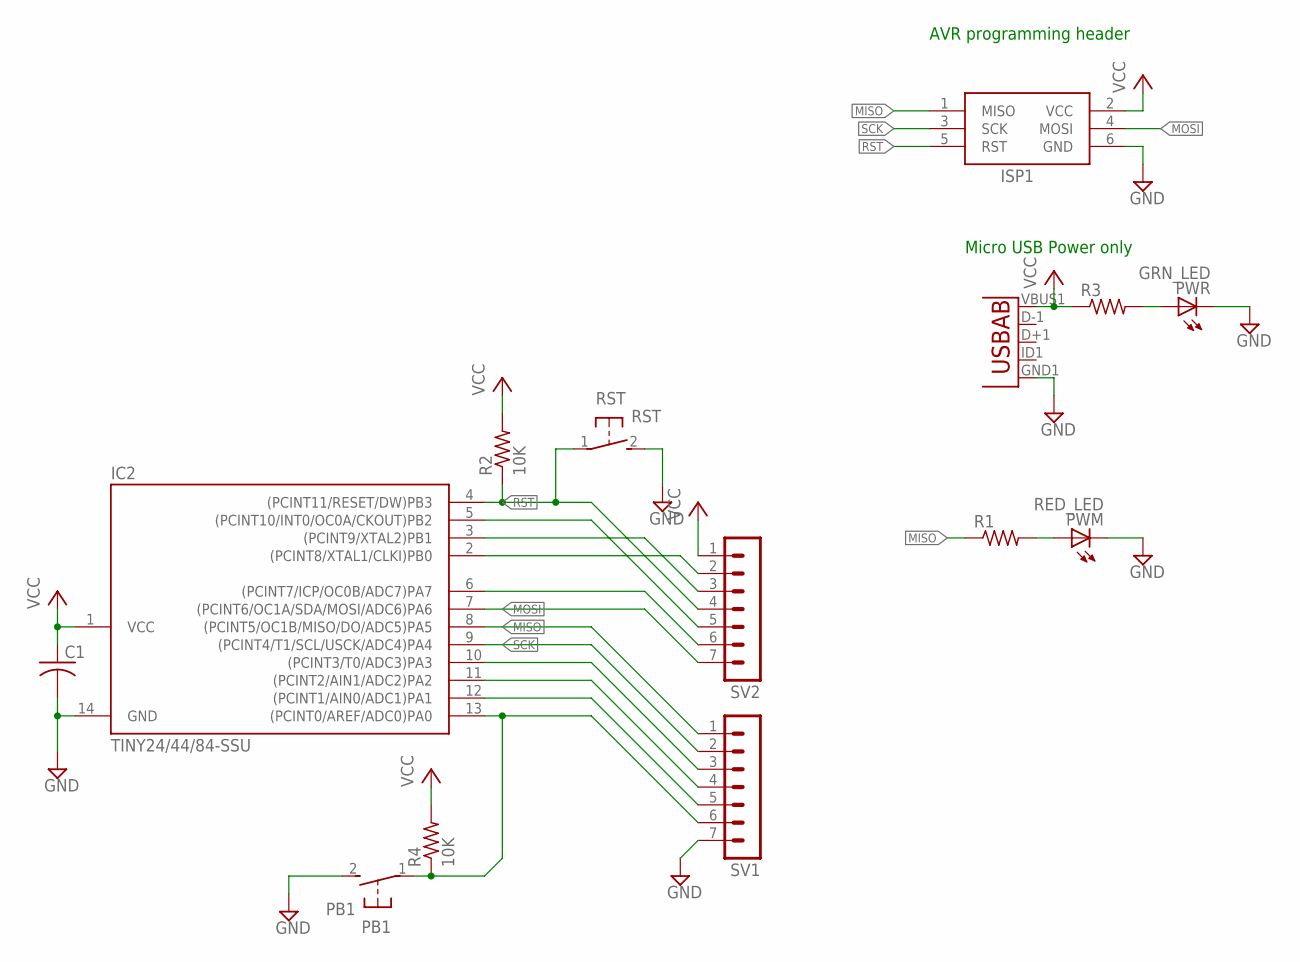
[picture p41: schematic ATTINY44_breakout.sch]

Parts:
C1: C-USC0805; C0805
IC2: TINY24/44/84-SSU; SOIC14
ISP1: AVRISP-6; AVRISP
PB1: PB1; DTSM-3
PWM: RED_LED; CHIPLED_0805
PWR: GRN_LED; CHIPLED_0805
R1, R3: R-US_R0805; R0805
R2, R4: 10K; R0805
RST: RST; DTSM-3
SV1, SV2: MA07-1
U1: USB""; USB-MICRO-SMD

Connections:
GND: C1.2, IC2.14 (GND), ISP1.6 (GND), PB1.2, PWM.C, PWR.C, RST.2, SV1.7, U1.GND1 (GND)
MISO: IC2.8 ((PCINT5/OC1B/MISO/DO/ADC5)PA5), ISP1.1 (MISO), R1.1, SV1.1
MOSI: IC2.7 ((PCINT6/OC1A/SDA/MOSI/ADC6)PA6), ISP1.4 (MOSI), SV2.7
unnamed: PWR.A, R3.2
unnamed: PWM.A, R1.2
unnamed: IC2.2 ((PCINT8/XTAL1/CLKI)PB0), SV2.2
unnamed: IC2.3 ((PCINT9/XTAL2)PB1), SV2.3
unnamed: IC2.5 ((PCINT10/INT0/OC0A/CKOUT)PB2), SV2.5
unnamed: IC2.6 ((PCINT7/ICP/OC0B/ADC7)PA7), SV2.6
PIN10: IC2.10 ((PCINT3/T0/ADC3)PA3), SV1.3
PIN11: IC2.11 ((PCINT2/AIN1/ADC2)PA2), SV1.4
PIN12: IC2.12 ((PCINT1/AIN0/ADC1)PA1), SV1.5
PIN13: IC2.13 ((PCINT0/AREF/ADC0)PA0), PB1.1, R4.1, SV1.6
RST: IC2.4 ((PCINT11/RESET/DW)PB3), ISP1.5 (RST), R2.1, RST.1, SV2.4
SCK: IC2.9 ((PCINT4/T1/SCL/USCK/ADC4)PA4), ISP1.3 (SCK), SV1.2
VCC: C1.1, IC2.1 (VCC), ISP1.2 (VCC), R2.2, R3.1, R4.2, SV2.1, U1.VBUS1 (VBUS)

Notes on the sheet:
AVR programming header
Micro USB Power only

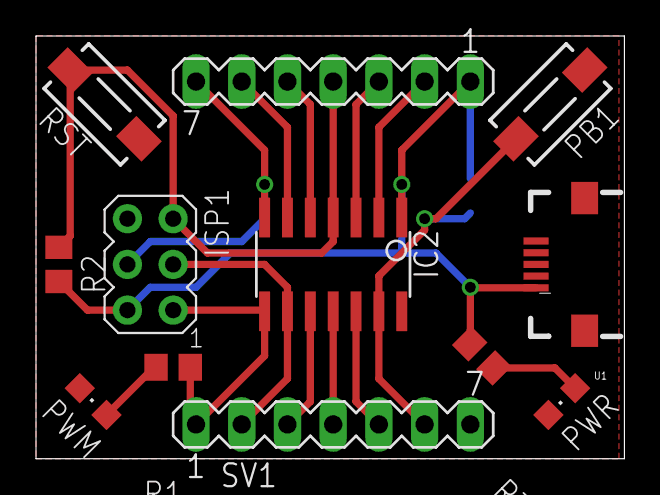
[picture p42: board ATTINY44_breakout.brd from above]

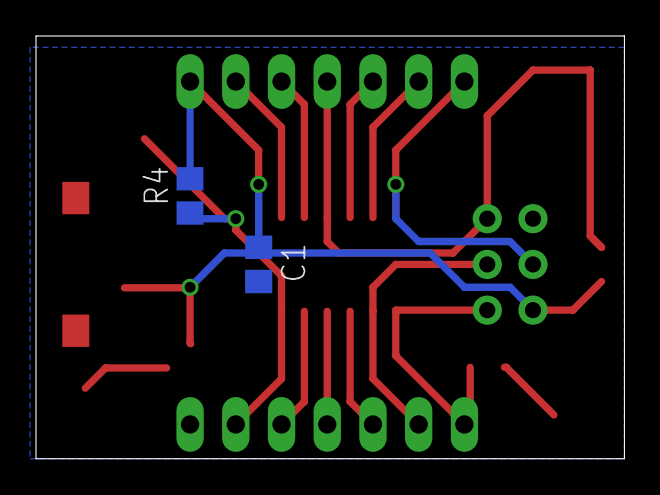
[picture p43: board ATTINY44_breakout.brd from below]

Board: 2 copper layers, 32.7 x 23.5 mm, 14 parts (2 on the bottom side), 16 nets.
