tjgilbert/ece411/Eagle/test boards/AVR85_test.brd

## EAGLE design Eagle/test boards/AVR85_test.brd (2016-10-16)

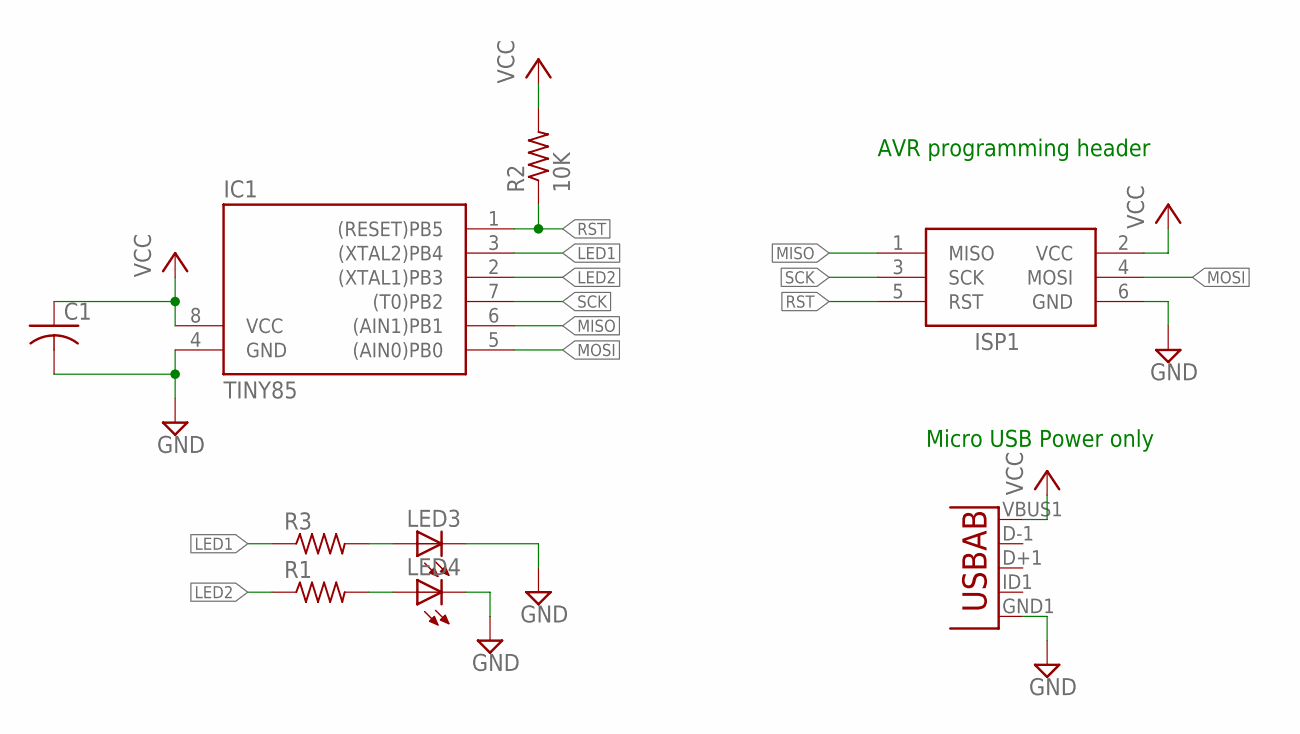
[picture p44: schematic AVR85_test.sch]

Parts:
C1: C-USC0805; C0805
IC1: TINY85; SOIC8
ISP1: AVRISP-6; AVRISP
LED3, LED4: LEDCHIPLED_0805; CHIPLED_0805
R1, R3: R-US_R0805; R0805
R2: 10K; R0805
U1: USB""; USB-MICRO-SMD

Connections:
GND: C1.2, IC1.4 (GND), ISP1.6 (GND), LED3.C, LED4.C, U1.GND1 (GND)
LED1: IC1.3 ((XTAL2)PB4), R3.1
LED2: IC1.2 ((XTAL1)PB3), R1.1
MISO: IC1.6 ((AIN1)PB1), ISP1.1 (MISO)
MOSI: IC1.5 ((AIN0)PB0), ISP1.4 (MOSI)
unnamed: LED3.A, R3.2
unnamed: LED4.A, R1.2
RST: IC1.1 ((RESET)PB5), ISP1.5 (RST), R2.1
SCK: IC1.7 ((T0)PB2), ISP1.3 (SCK)
VCC: C1.1, IC1.8 (VCC), ISP1.2 (VCC), R2.2, U1.VBUS1 (VBUS)

Notes on the sheet:
AVR programming header
Micro USB Power only

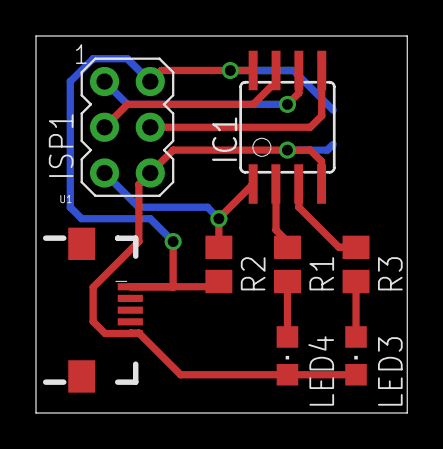
[picture p45: board AVR85_test.brd from above]

Board: 2 copper layers, 20.6 x 20.9 mm, 9 parts (1 on the bottom side), 10 nets.
