tjgilbert/ece411/(commit log)

2016-10-12 Added AVR test board schematics
    [AVRtest.brd, AVRtest.sch]
2016-10-16 Added ATTINY44 breakout board
    [ATTINY44.brd, ATTINY44.sch, AVRtest.brd]
2016-10-23 added code section
    [ATTINY44.brd]
2016-11-02 Updated uC code
    [ATTINY44_breakout.brd, ATTINY44_breakout.sch, AVR85_test.brd, AVR85_test.sch, ChargerBase.brd, ChargerBase.sch]
2016-11-02 Updated schematic
    [ChargerBase.brd, ChargerBase.sch]
2016-11-03 Create LTspice schematics- Receiver
2016-11-03 Uploaded schematics
    [ChargerBase.brd, ChargerBase.sch, Receiver.sch]
2016-11-04 Moved breakout test boards to own folder
    [ATTINY44_breakout.brd, ATTINY44_breakout.sch, AVR85_test.brd, AVR85_test.sch]
2016-11-04 deleted corrupt file
    [T10_ChargerBase.brd]
2016-11-04 renamed file
    [T10_ChargerBase.brd]
2016-11-08 changed pwm mode
2016-11-10 Board files and update uC program
    [T10_ChargerBase.brd, T10_ChargerBase.sch, T10_Receiver.brd, T10_Receiver.sch]
2016-11-10 Complementary Symmetry Amplifier Output Stage Spice Schematic
    Spice Schematic of Comp Sym Output stage as built and tested in the lab. The DC node voltages were pretty close to the real thing, I didn't measure the currents.
2016-11-11 Add files via upload
    MOSFET Experiments, see MOSFET_Notes for description of setup
2016-11-12 Add files via upload
    This schematic is the one I am currently working on, in the simulation I am driving a parallel combination of a 47nF cap with 22uH inductor, their resonant frequency is 125kHz. I built and tested this circuit with TL740cn JFET op amps. they can handle this high frequency.
    I'm currently working to get the output bigger than a few tens of mV with the load hooked up. I am going to simulate next instead of driving the inductor and cap, driving the output stage. I'm going to simulate with a class A output stage single BJT 4 resistor bias circuit.
    Please play around with feeding this filtered signal into different output driving stages.
    I built the circuit using the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
2016-11-16 Boards + schematics rev2
    [ece411-t10-ChargerBase.brd, ece411-t10-ChargerBase.sch, ece411-t10-Receiver.brd, ece411-t10-Receiver.sch]
2016-11-16 changed silkscreen
    [ece411-t10-ChargerBase.brd, ece411-t10-Receiver.brd]
2016-11-16 cleaned up schematic. fixed minor ERC error
    [ece411-t10-ChargerBase.brd, ece411-t10-ChargerBase.sch]
2016-11-24 Datasheet MOSFET
    datasheet
2016-11-24 Add files via upload
    Changed test case pdf to image file for in line addition to test wiki
2016-11-24 Add files via upload
    5.2.1 and 5.2.2 were split in to two tests late last night. Adjusting test case forms to match the change
2016-12-02 IO working on program
    [ISP_POGO_programmer.brd, ISP_POGO_programmer.sch, ece411-t10-Receiver.sch]
2016-12-03 Powerpoint for final presentation
2016-12-08 clean up
    [ece411-t10-ChargerBase.brd, ece411-t10-ChargerBase.sch, ece411-t10-Receiver.brd, ece411-t10-Receiver.sch]
